sishii2026-ctr/effector/(commit log)

2026-06-16 readme更新、コード追加
2026-06-17 音声ファイル追加
2026-06-17 readme更新
2026-06-17 音声リンクに変更
2026-06-19 ビット音エフェクト機能追加コード
2026-06-19 ビット音エフェクト機能の追加コード
2026-06-19 コード修正
2026-06-25 コード更新
2026-06-25 不要ファイル削除
2026-06-26 ファイル整理
2026-06-29 readme、コード更新
2026-06-30 動画アップ
